jfm92/everAliveSensor/everAlive_Enclosure/everAlive_Enclosure_Bottom.stl

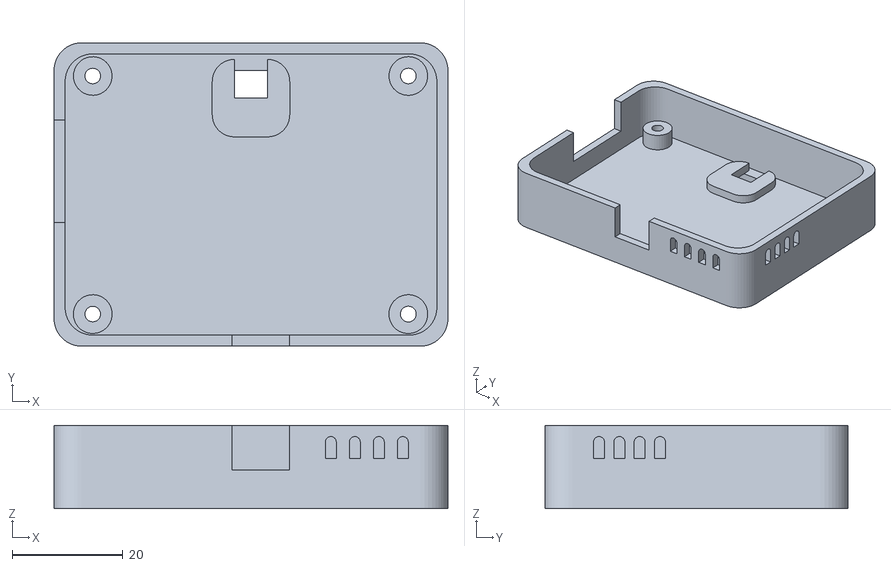
[picture p2: CAD file, 2026-05-23]
everAlive_Enclosure/everAlive_Enclosure_Bottom.stl
71.2 x 54.8 x 15.0
