jfm92/everAliveSensor/everAliveSensor_PCB/everAliveSensor_PCB.kicad_pcb

## KiCad design everAliveSensor_PCB/everAliveSensor_PCB.kicad_pcb (2026-05-23)

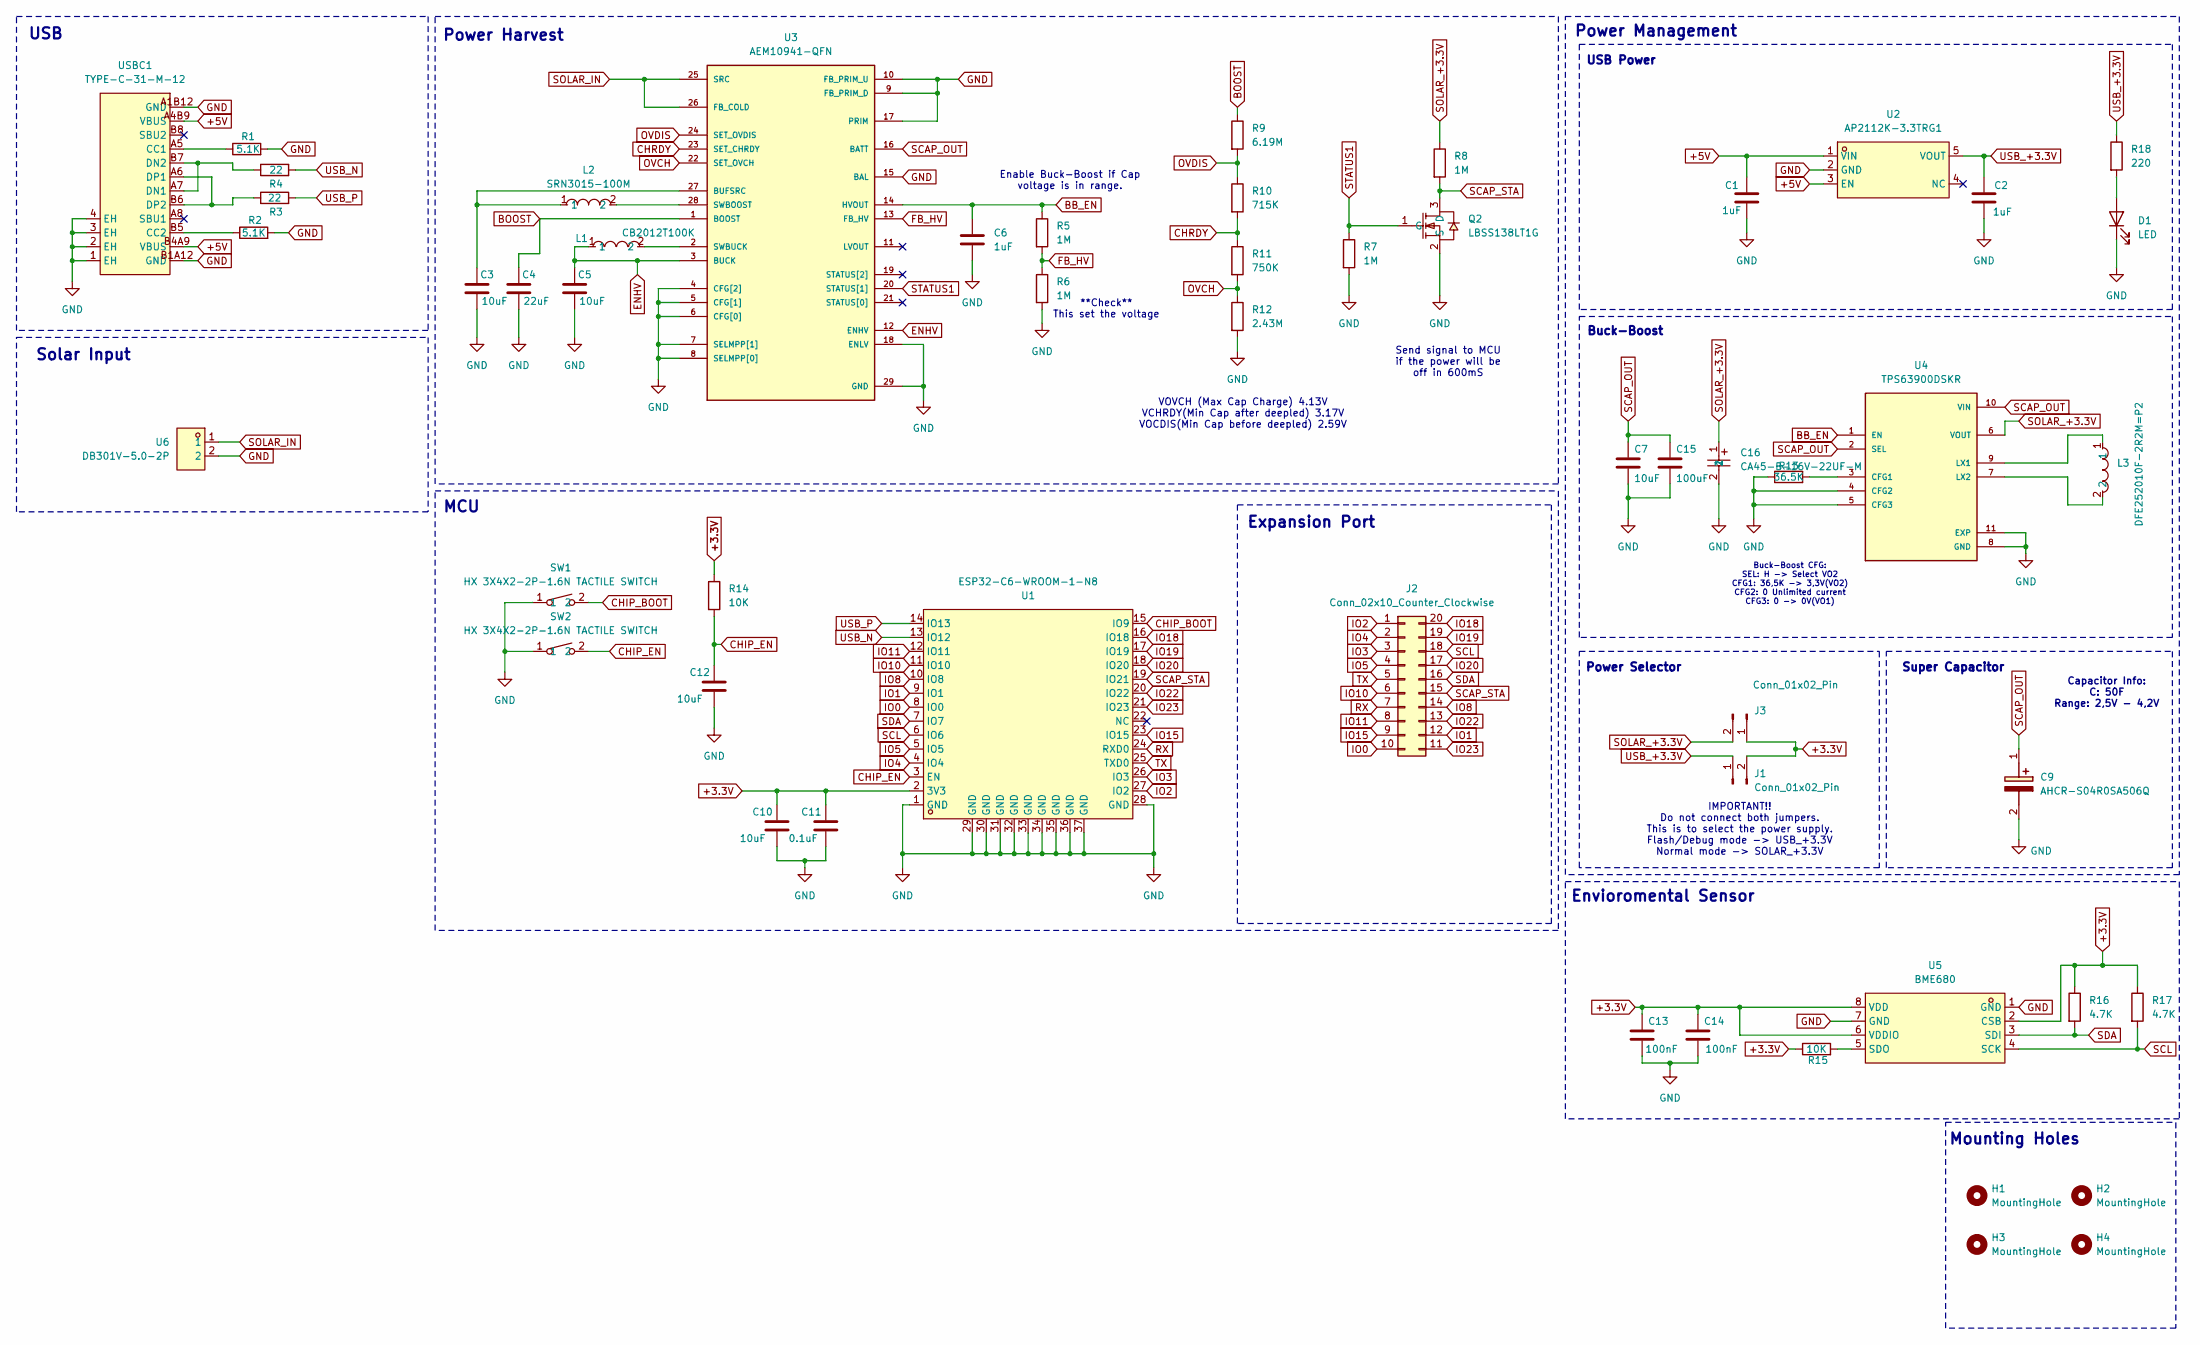
[picture p3: schematic everAliveSensor_PCB.kicad_sch, EverAlive]

Parts:
C1, C2, C6: 1uF; C_0805_2012Metric_Pad1.18x1.45mm_HandSolder
C3, C5, C7, C10, C12: 10uF; C_0805_2012Metric_Pad1.18x1.45mm_HandSolder
C4: 22uF; C_0805_2012Metric_Pad1.18x1.45mm_HandSolder
C9: AHCR-S04R0SA506Q; CAPPRD350W65D800H2700; Mouser Part Number 815-AHCR-S04R0SA506Q
C11: 0.1uF; C_0805_2012Metric_Pad1.18x1.45mm_HandSolder
C13, C14: 100nF; C_0805_2012Metric_Pad1.18x1.45mm_HandSolder
C15: 100uF; C_0603_1608Metric_Pad1.08x0.95mm_HandSolder
C16: CA45-B-16V-22UF-M; CAP-SMD_L3.5-W2.8-R-RD; MPN CA45-B-16V-22uF-M; LCSC Part C140371
D1: LED; LED_0805_2012Metric_Pad1.15x1.40mm_HandSolder
H1, H2, H3, H4: MountingHole; MountingHole_2.7mm_M2.5_Pad
J1, J3: Conn_01x02_Pin; PinHeader_1x02_P2.54mm_Vertical
J2: Conn_02x10_Counter_Clockwise; PinHeader_2x10_P2.54mm_Vertical
L1: CB2012T100K; L0805; MPN CB2012T100K; LCSC Part C223169
L2: SRN3015-100M; IND-SMD_L3.0-W3.0; MPN SRN3015-100M; LCSC Part C780208
L3: DFE252010F-2R2M=P2; L1008; MPN DFE252010F-2R2M=P2; LCSC Part C488330
Q2: LBSS138LT1G; SOT-23_L2.9-W1.3-P1.90-LS2.4-BR; MPN LBSS138LT1G; LCSC Part C8490
R1, R2: 5.1K; R_0805_2012Metric_Pad1.20x1.40mm_HandSolder
R3, R4: 22; R_0805_2012Metric_Pad1.20x1.40mm_HandSolder
R5, R6, R7, R8: 1M; R_0805_2012Metric_Pad1.20x1.40mm_HandSolder
R9: 6.19M; R_0805_2012Metric_Pad1.20x1.40mm_HandSolder
R10: 715K; R_0805_2012Metric_Pad1.20x1.40mm_HandSolder
R11: 750K; R_0805_2012Metric_Pad1.20x1.40mm_HandSolder
R12: 2.43M; R_0805_2012Metric_Pad1.20x1.40mm_HandSolder
R13: 36.5K; R_0805_2012Metric_Pad1.20x1.40mm_HandSolder
R14, R15: 10K; R_0805_2012Metric_Pad1.20x1.40mm_HandSolder
R16, R17: 4.7K; R_0805_2012Metric_Pad1.20x1.40mm_HandSolder
R18: 220; R_0805_2012Metric_Pad1.20x1.40mm_HandSolder
SW1, SW2: HX 3X4X2-2P-1.6N TACTILE SWITCH; KEY-SMD_L4.0-W3.0-LS4.9-1; MPN HX 3x4x2-2P-1.6N TACTILE SWITCH; LCSC Part C49234124
U1: ESP32-C6-WROOM-1-N8; WIRELM-SMD_ESP32-C6-WROOM-1; MPN ESP32-C6-WROOM-1-N8; LCSC Part C5366877
U2: AP2112K-3.3TRG1; SOT-25-5_L2.9-W1.6-P0.95-LS2.8-BL; MPN AP2112K-3.3TRG1; LCSC Part C51118
U3: AEM10941-QFN; QFN50P500X500X90-29N; PARTREV 1.4
U4: TPS63900DSKR; IC_TPS63900DSKR; PARTREV D
U5: BME680; LGA-8_L3.0-W3.0-P0.80-TR; MPN BME680; LCSC Part C125972
U6: DB301V-5.0-2P; CONN-TH_2P-P5.00_L7.6-W10.0; MPN DB301V-5.0-2P-BU-S; LCSC Part C395882
USBC1: TYPE-C-31-M-12; USB-C_SMD-TYPE-C-31-M-12_1; MPN TYPE-C-31-M-12; LCSC Part C165948

Connections:
+3.3V: C10.1, C11.1, C13.1, C14.1, J1.2, J3.1, R14.1, R15.1, R16.1, R17.1, U1.2 (3V3), U5.2 (CSB), U5.6 (VDDIO), U5.8 (VDD)
+5V: C1.1, U2.1 (VIN), U2.3 (EN), USBC1.A4B9 (VBUS), USBC1.B4A9 (VBUS)
BB_EN: C6.1, R5.1, U3.14 (HVOUT), U4.1 (EN)
BOOST: C4.1, R9.1, U3.1 (BOOST)
CHIP_BOOT: SW1.2, U1.15 (IO9)
CHIP_EN: C12.1, R14.2, SW2.2, U1.3 (EN)
CHRDY: R10.2, R11.1, U3.23 (SET_CHRDY)
ENHV: C5.1, L1.1, U3.3 (BUCK), U3.12 (ENHV)
FB_HV: R5.2, R6.1, U3.13 (FB_HV)
GND: C1.2, C2.2, C3.2, C4.2, C5.2, C6.2, C7.2, C9.2 (-), C10.2, C11.2, C12.2, C13.2, C14.2, C15.2, C16.2, D1.1 (K), Q2.2 (S), R1.2, R2.2, R6.2, R7.2, R12.2, R13.1, SW1.1, SW2.1, U1.1 (GND), U1.28 (GND), U1.29 (GND), U1.30 (GND), U1.31 (GND), U1.32 (GND), U1.33 (GND), U1.34 (GND), U1.35 (GND), U1.36 (GND), U1.37 (GND), U2.2 (GND), U3.4 (CFG[2]), U3.5 (CFG[1]), U3.6 (CFG[0]), U3.7 (SELMPP[1]), U3.8 (SELMPP[0]), U3.9 (FB_PRIM_D), U3.10 (FB_PRIM_U), U3.15 (BAL), U3.17 (PRIM), U3.18 (ENLV), U3.29 (GND), U4.4 (CFG2), U4.5 (CFG3), U4.8 (GND), U4.11 (EXP), U5.1 (GND), U5.7 (GND), U6.2, USBC1.1 (EH), USBC1.2 (EH), USBC1.3 (EH), USBC1.4 (EH), USBC1.A1B12 (GND), USBC1.B1A12 (GND)
IO0: J2.10, U1.8 (IO0)
IO1: J2.12, U1.9 (IO1)
IO2: J2.1, U1.27 (IO2)
IO3: J2.3, U1.26 (IO3)
IO4: J2.2, U1.4 (IO4)
IO5: J2.4, U1.5 (IO5)
IO8: J2.14, U1.10 (IO8)
IO10: J2.6, U1.11 (IO10)
IO11: J2.8, U1.12 (IO11)
IO15: J2.9, U1.23 (IO15)
IO18: J2.20, U1.16 (IO18)
IO19: J2.19, U1.17 (IO19)
IO20: J2.17, U1.18 (IO20)
IO22: J2.13, U1.20 (IO22)
IO23: J2.11, U1.21 (IO23)
unnamed: D1.2 (A), R18.2
unnamed: C3.1, L2.1, U3.27 (BUFSRC)
unnamed: L2.2, U3.28 (SWBOOST)
unnamed: L1.2, U3.2 (SWBUCK)
unnamed: R13.2, U4.3 (CFG1)
unnamed: L3.1, U4.9 (LX1)
unnamed: L3.2, U4.7 (LX2)
unnamed: R15.2, U5.5 (SDO)
unnamed: R1.1, USBC1.A5 (CC1)
unnamed: R2.1, USBC1.B5 (CC2)
unnamed: R4.1, USBC1.A7 (DN1), USBC1.B7 (DN2)
unnamed: R3.1, USBC1.A6 (DP1), USBC1.B6 (DP2)
OVCH: R11.2, R12.1, U3.22 (SET_OVCH)
OVDIS: R9.2, R10.1, U3.24 (SET_OVDIS)
RX: J2.7, U1.24 (RXD0)
SCAP_OUT: C7.1, C9.1 (+), C15.1, U3.16 (BATT), U4.2 (SEL), U4.10 (VIN)
SCAP_STA: J2.15, Q2.3 (D), R8.2, U1.19 (IO21)
SCL: J2.18, R17.2, U1.6 (IO6), U5.4 (SCK)
SDA: J2.16, R16.2, U1.7 (IO7), U5.3 (SDI)
SOLAR_+3.3V: C16.1, J3.2, R8.1, U4.6 (VOUT)
SOLAR_IN: U3.25 (SRC), U3.26 (FB_COLD), U6.1
STATUS1: Q2.1 (G), R7.1, U3.20 (STATUS[1])
TX: J2.5, U1.25 (TXD0)
USB_+3.3V: C2.1, J1.1, R18.1, U2.5 (VOUT)
USB_N: R4.2, U1.13 (IO12)
USB_P: R3.2, U1.14 (IO13)

Notes on the sheet:
Capacitor Info: C: 50F Range: 2,5V - 4,2V
Mounting Holes
Super Capacitor
Enable Buck-Boost if Cap voltage is in range.
Send signal to MCU if the power will be off in 600mS
VOVCH (Max Cap Charge) 4.13V VCHRDY(Min Cap after deepled) 3.17V VOCDIS(Min Cap before deepled) 2.59V
Solar Input
Power Selector
Power Management
Buck-Boost
Power Harvest
Expansion Port
Envioromental Sensor
IMPORTANT!! Do not connect both jumpers. This is to select the power supply. Flash/Debug mode -> USB_+3.3V Normal mode -> SOLAR_+3.3V
**Check** This set the voltage
Buck-Boost CFG: SEL: H -> Select VO2 CFG1: 36,5K -> 3,3V(VO2) CFG2: 0 Unlimited current CFG3: 0 -> 0V(VO1)
USB Power
USB
MCU

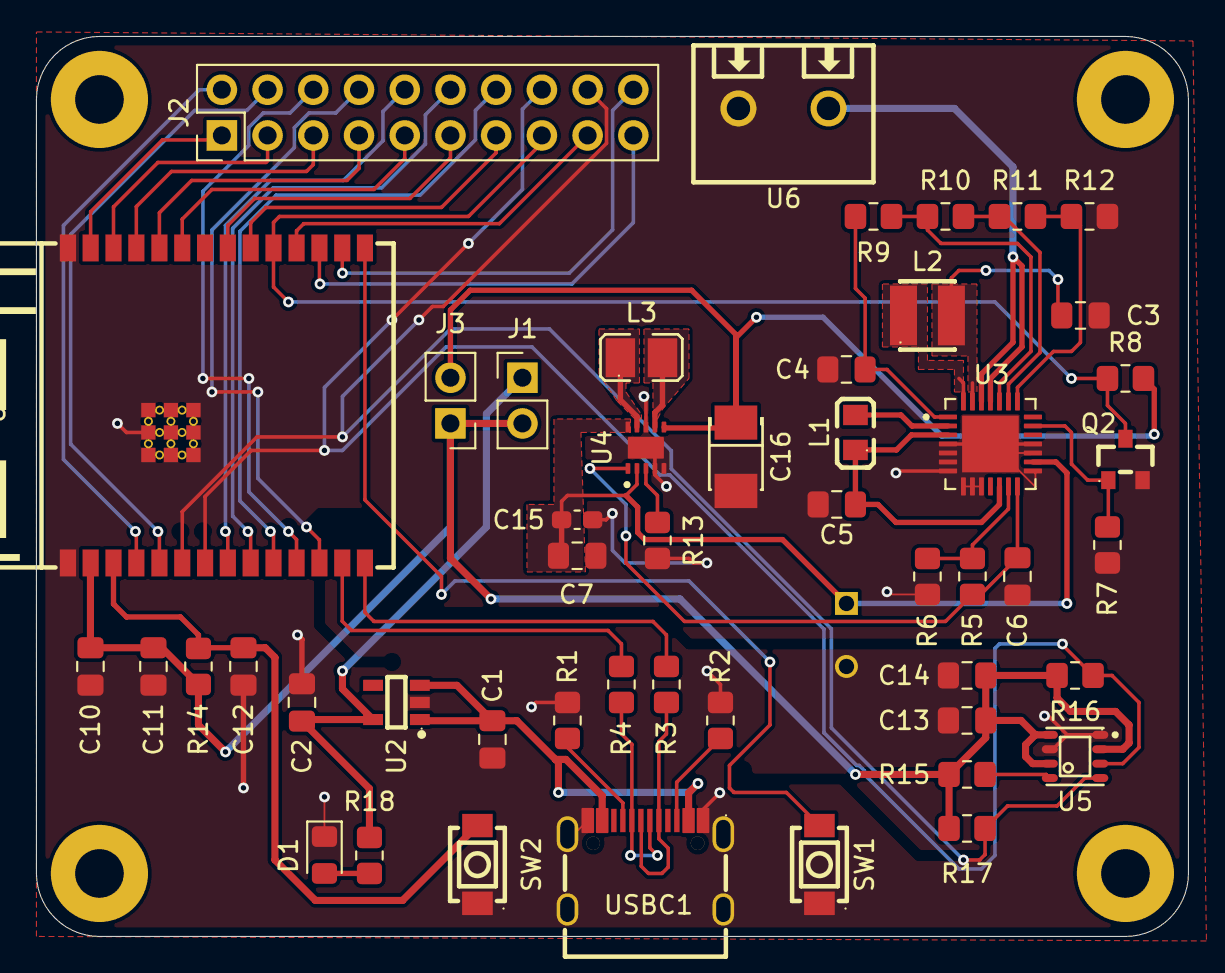
[picture p4: board everAliveSensor_PCB.kicad_pcb from above]

Board: 2 copper layers, 64.0 x 50.0 mm, 54 parts (1 on the bottom side), 51 nets.
