jfm92/everAliveSensor/(commit log)

2026-05-23 Adding PCB design
    [everAliveSensor_PCB.kicad_pcb, everAliveSensor_PCB.kicad_sch]
2026-05-23 Adding device enclosure
    [everAlive_Enclosure_Bottom.stl, everAlive_Enclosure_Top.stl]
2026-05-23 Adding demo example to interact with everAlive sensor
